sebasvila/VentiladorUPCManresa/golfes/Doc/README.md

# Available developments

*  A non-invasive ventilator has [been developed](https://www.vilaweb.cat/noticies/investigadors-de-la-ub-desenvolupen-un-respirador-no-invasiu-de-baix-cost-per-a-zones-amb-pocs-recursos/) by researchers of UB. They have published a paper in 
*European Respiratory Journal* and allegedly there are open specifications and code.

## Oxygen

*  The [Discord channel](https://discordapp.com/channels/688696001938456587/689935740435431473) of the proect.

*  [Legal and technical docs](https://github.com/ProtofyTeam/OxyGEN/tree/master/oxygen_IP/OxygenIP_V1/legal%20and%20tech%20docs) of the oxygen project.

*  [Main](https://github.com/ProtofyTeam/OxyGEN) GitHub page of the project

## GPA Innova RESPIRA

*  One of the industrial, commercial (?) designs. [Link](https://www.gpainnova.com/our-projects-respira). There is a [nice web page](https://en.respiradevice.com/). Performance and features seem quite standard.

## Medtronic

MedTronic has published the design of the PB650 Ventilator. Files can be downloaded after registration [here](https://www.medtronic.com/us-en/e/open-files/thank-you.html)

# Sensors

* [Honeywell Flow Sensor](https://es.rs-online.com/web/p/sensores-e-indicadores-de-flujo/6237933/) (200 SLPM).

# Electronics
*  [Pololu DRV8825 ](https://www.pololu.com/product/2133)

*  A [brushless motor driver chip](https://www.allegromicro.com/en/products/motor-drivers/bldc-drivers/a4960) in case we decide to pursue a design based on turbines. 

# Software

*  Cosa
*  Protothreads
*
