sebasvila/VentiladorUPCManresa/golfes/SensorPressio.md

Sensor pressió ABPLLND060MGAA3

Alimentació   : 3.3V
Fons d'escala : 60mbar

1mbar=1.0197 cmH2O

Tensió obtinguda: v

m=60/(2.97-0.33)
n=-0.75
P=m*v+n
