sebasvila/VentiladorUPCManresa/golfes/ESP32experiments/ESP32devkit1_pinout.png

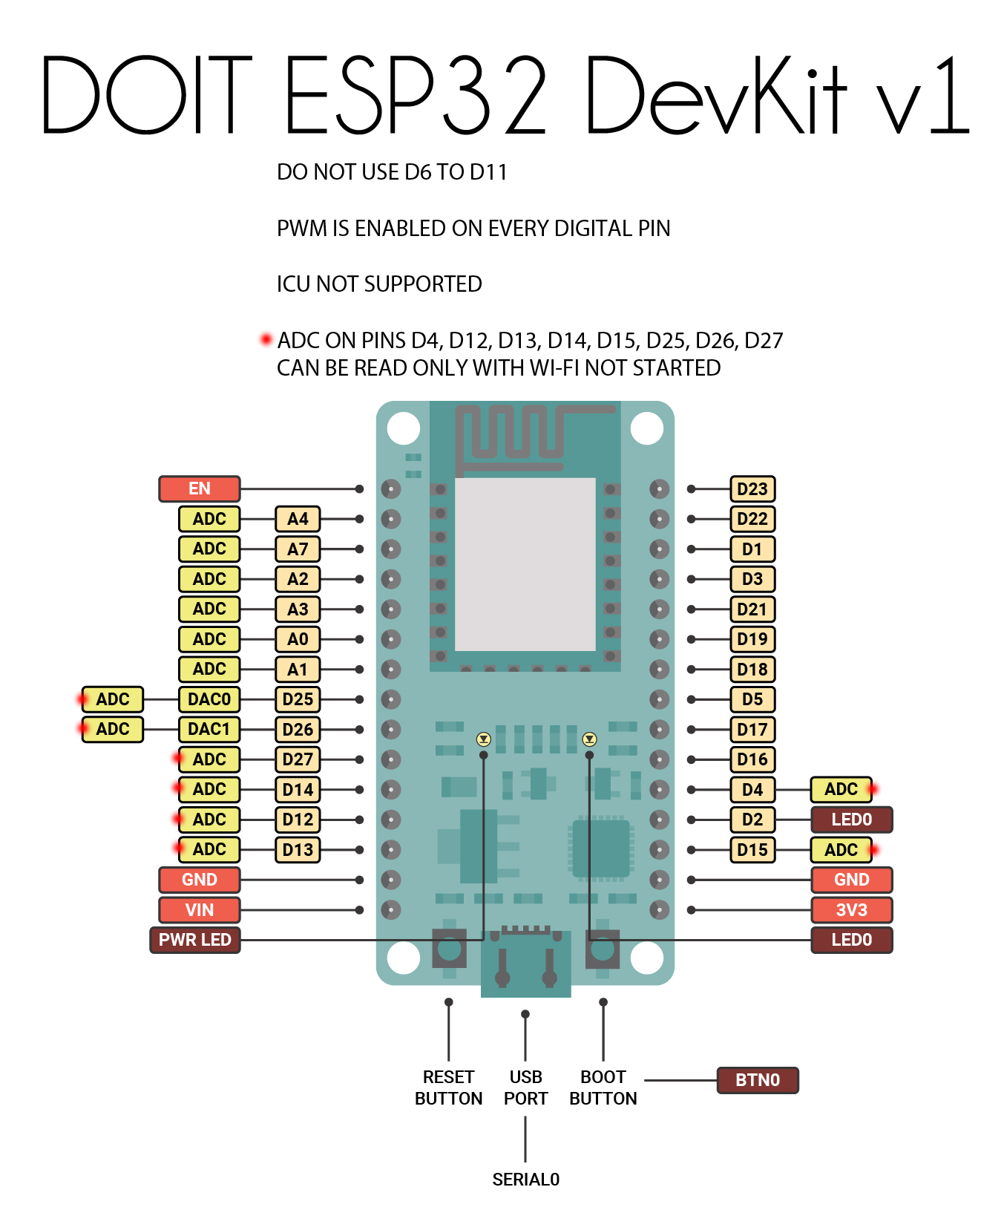
golfes/ESP32experiments/ESP32devkit1_pinout.png
