sebasvila/VentiladorUPCManresa/golfes/experiments/Grbl_Pin_Layout.png

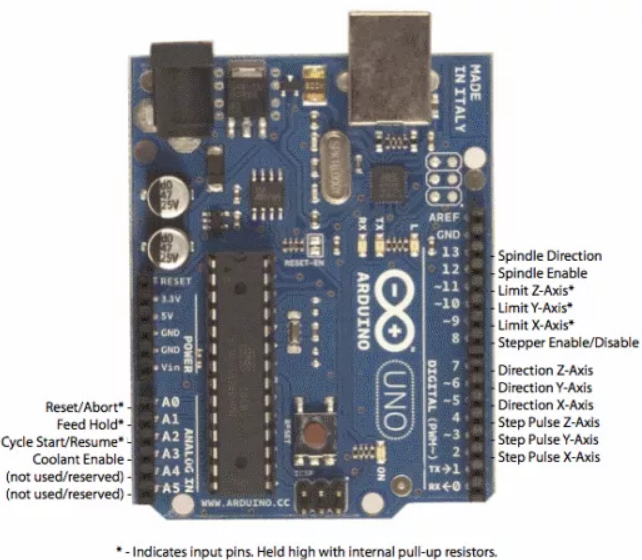
golfes/experiments/Grbl_Pin_Layout.png
