sebasvila/VentiladorUPCManresa/(commit log)

2020-03-29 Afegit sketch inicial ESP32
2020-03-30 Create ArduinoTempsReal
2020-04-03 First Motor Movement
2020-04-05 Added MotorRampWithTimer
2020-04-06 Added MotorSineWithTimer
2020-04-07 added ESP32experiments folder
2020-04-13 First try to get a better correction
    [MotorSineWithTimerCorrection.ino]
2020-04-14 Afegit modul i test per ADC
2020-04-14 adc tested. Some function names refactored
2020-04-17 Redesign of motor driver according to lab experience this morning
2020-04-17 Modified according of new motor module
2020-04-18 Change implementation of `pin_t: `pin` field is now the mask of the pin instead of the pin number. This avoids recomputing the mask at every operation call.
2020-04-18 Revised timer configuration according datasheet
2020-04-18 Added a debounced switch module with its tests.
2020-04-19 Rationalize switch set of query operations.
2020-04-19 Handler is now a pointer to internal slot. Makes more efficient query functions.
2020-04-20 Solved a bug. Module adc needs a refactoring.
2020-04-20 New DELAY Protothreads macro. Some tests adopted new macro. New test for switch module.
2020-04-20 Refactored adc.c. Rationalized function names. Applied to tests.
2020-04-24 Enriched to allow for other Arduino models
2020-04-25 First advances in new adc module arch
2020-05-01 Allow constant voltage channels to be selected. Change first conversion parameters to avoid potential interaction with Aref.
2020-05-04 Test funcionant de la llibreria LCD. Faltaria adaptar als protothreads.
2020-05-04 Fitxer .gitignore afegit per tal de no mostrar els compilats
2020-05-06 Serial drivers added
2020-05-10 Add a notes dir and a note file about i2c
2020-05-10 Esquelet de notes sobre lcd
2020-05-13 Comentaris del que cal revisar del mòdul en algun moment.
2020-05-25 Add scaffolding for i2c low level driver. Advance implementing it.
2020-12-21 Add golfes (attic) to store historical material
2020-12-23 Modificat el Makefile per que generi la lliberia. Petits errors a switch i ticker. Manquen detalls per afinar amb i2c i els tests.
2020-12-23 Motor header file documented
2020-12-23 Redo the adc doc to have a better example of structure
2020-12-27 Add plantuml ans math plugins to sphinx. Show how to use plantuml in adc.rst
2020-12-27 I2C hardware utility functions implemented
2021-01-03 I2C library changes
2021-01-07 I2C queue "const" definitions re-implemented.
2021-01-08 I2C Lib small modifications and comments
2021-01-14 Implement i2c_sandr()
2021-01-14 Add i2c documentation
